darthcoder1/evproj-APC/schematics/Protoboard v0.1/Schematic_EV-AuxilaryUnity_20180824095853.pdf

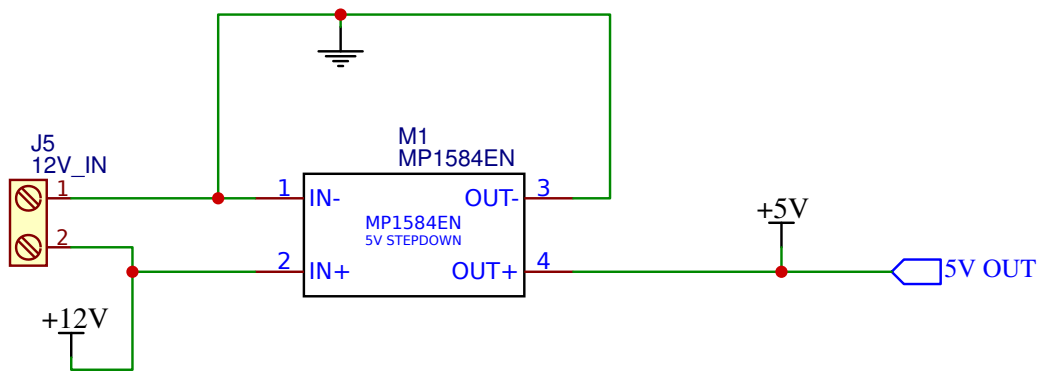
[picture p1: page 1]
TITLE:; 12V to 5V PowerStage; REV: 1.0; Date:; Sheet: 1/1; EasyEDA V5.6.15; Drawn By: darthcoder1; 5V OUT; OUT- 3; OUT+ 4; MP1584EN 5V STEPDOWN

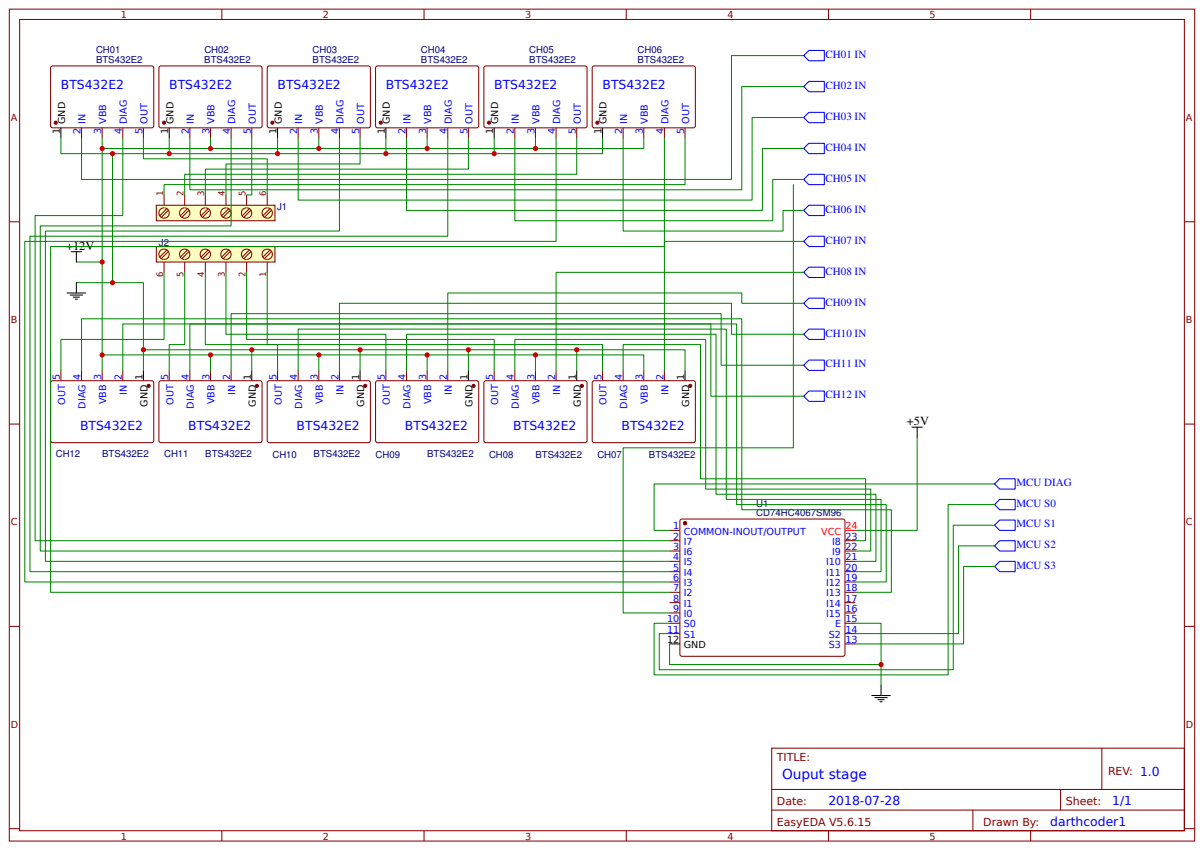
[picture p2: page 2]
TITLE:; Ouput stage; REV: 1.0; Date:; Sheet: 1/1; BTS432E2; GND 1; VBB 3; DIAG 4; OUT 5; BTS432E2GND ¹ IN ² VBB 3 DIAG ⁴ OUT 5; BTS432E2 GND ¹ IN ² VBB 3 DIAG ⁴ OUT 5; COMMON-INOUT/OUTPUT 1 I7 2 I6 3 I5 4 I4 5 I3 6 I2 7 I1 8 I0 9 S0 10 S1 11; GND 12; S3 13 S2 14 E 15 I15 16 I14 17 I13 18 I12 19 I11 20 I10 21 I9 22 I8 23 VCC 24; MCU DIAG; MCU S0; MCU S1; MCU S2; MCU S3

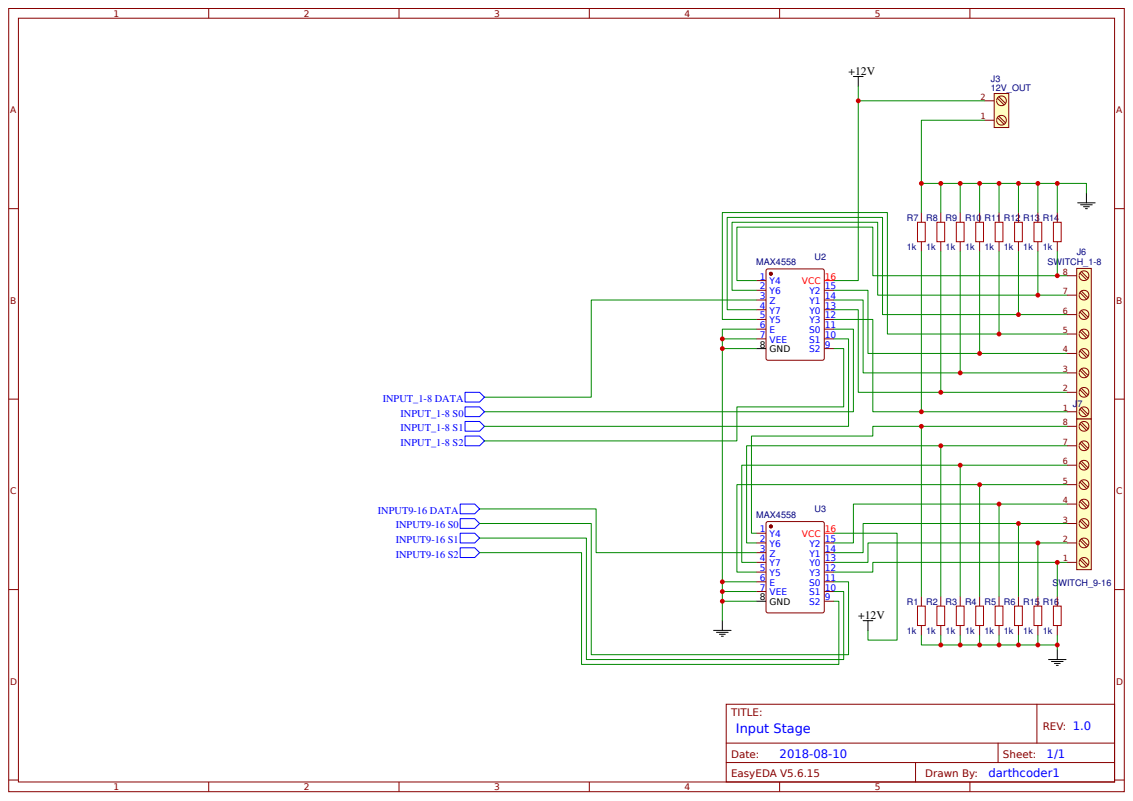
[picture p3: page 3]

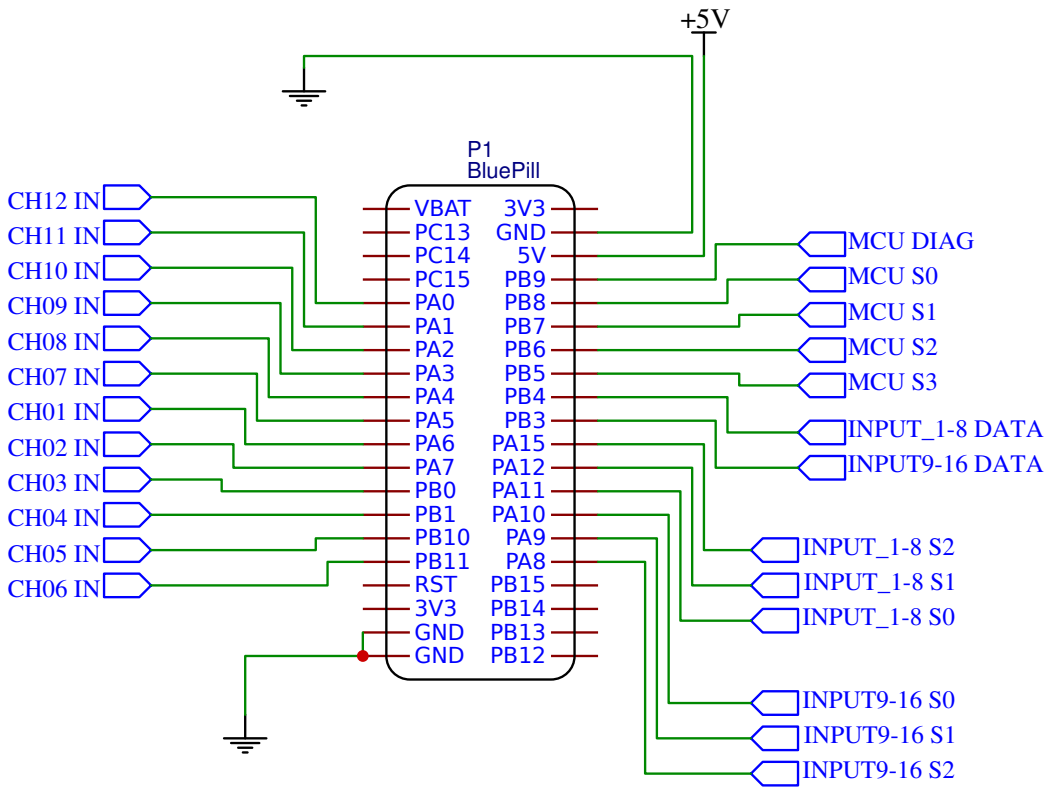
[picture p4: page 4]
TITLE:; MCU Stage; REV: 1.0; Date:; Sheet: 1/1; BluePill; VBAT PC13 PC14 PC15 PA0 PA1 PA2 PA3 PA4 PA5 PA6 PA7 PB0 PB1 PB10 PB11 RST 3V3 GND GND; 3V3 GND 5V PB9 PB8 PB7 PB6 PB5 PB4 PB3 PA15 PA12 PA11 PA10 PA9 PA8 PB15 PB14 PB13 PB12; MCU DIAG MCU S0 MCU S1 MCU S2 MCU S3; INPUT_1-8 DATA; INPUT_1-8 S0; INPUT_1-8 S1; INPUT_1-8 S2; INPUT9-16 DATA; INPUT9-16 S0 INPUT9-16 S1 INPUT9-16 S2
