darthcoder1/evproj-APC/(commit log)

2019-01-19 Board scafollding
2019-01-23 Added TODO tasks to fix issues with the PCB
2019-01-23 Implemented direct input to output mapping to switch the output channels for testing
2019-01-25 Implemented setup of timers for timer interrupts
2019-01-26 Implemented TIM2 interrupt handler
2019-01-31 Added pin mapping for output channel diagnosis
    The BTS432E2 provides a diagnosis pin. The diagnosis pins of the
    outputchannels are read by a 74HC4067.
2019-01-31 Refactored timer initialization and setup second timer
    One timer is pulsing every 500ms and switches the boards LED on and
    off. The second timer is supposed to give the pulse for the direction
    indicators and is currently setup to 1s.
2019-01-31 Implemented turn light pulse
    The timer and interrupts are started, resetted and stopped according
    to the driver control input.
    [pin_map.h, user_main.c]
2019-01-31 Refactored timer intialization into hw_utils.h/c
    hw_utils.h/c will host utility functions to interface with the
    hardware.
